pdsuthar10/Automatic-Fire-Fighting-Robot/README.md

# Automatic-Fire-Fighting-Robot
Worked on an automatic fire extinguishing robot using arduino uno as the microcontroller. I wrote the code in arduino platform which uses ultrasonic sensors to detect obstacles and IR detectors for detection of fire maintaining its original route.
